wenners/wordclock/drawings/Atemega-328.png

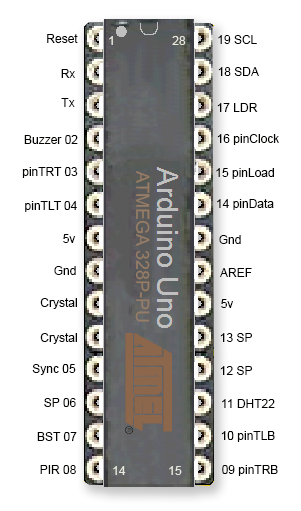
drawings/Atemega-328.png
