wenners/wordclock/drawings/MDF_Bus_Bar.png

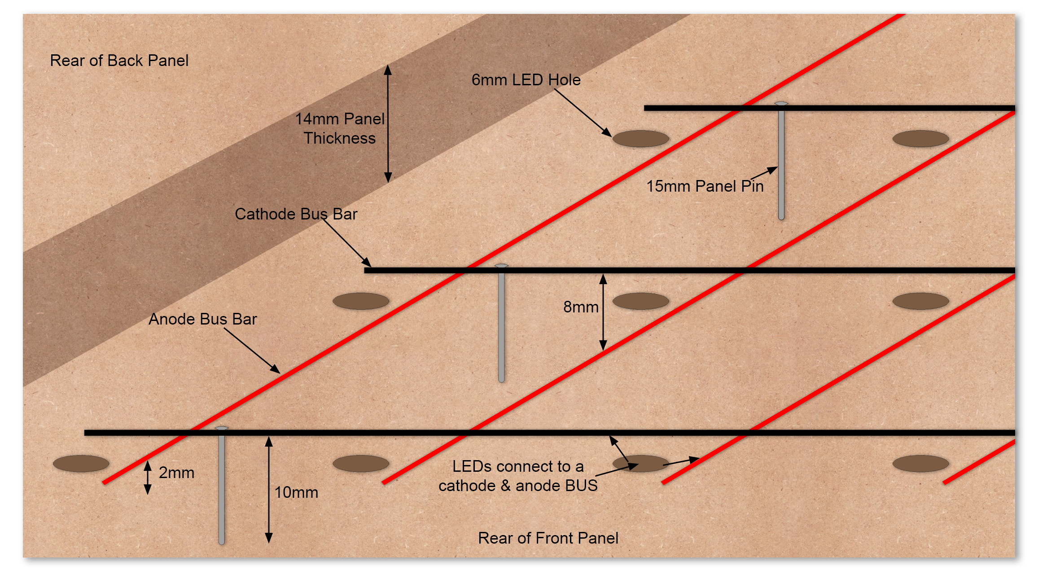
drawings/MDF_Bus_Bar.png
