wenners/wordclock/drawings/Module_layout.png

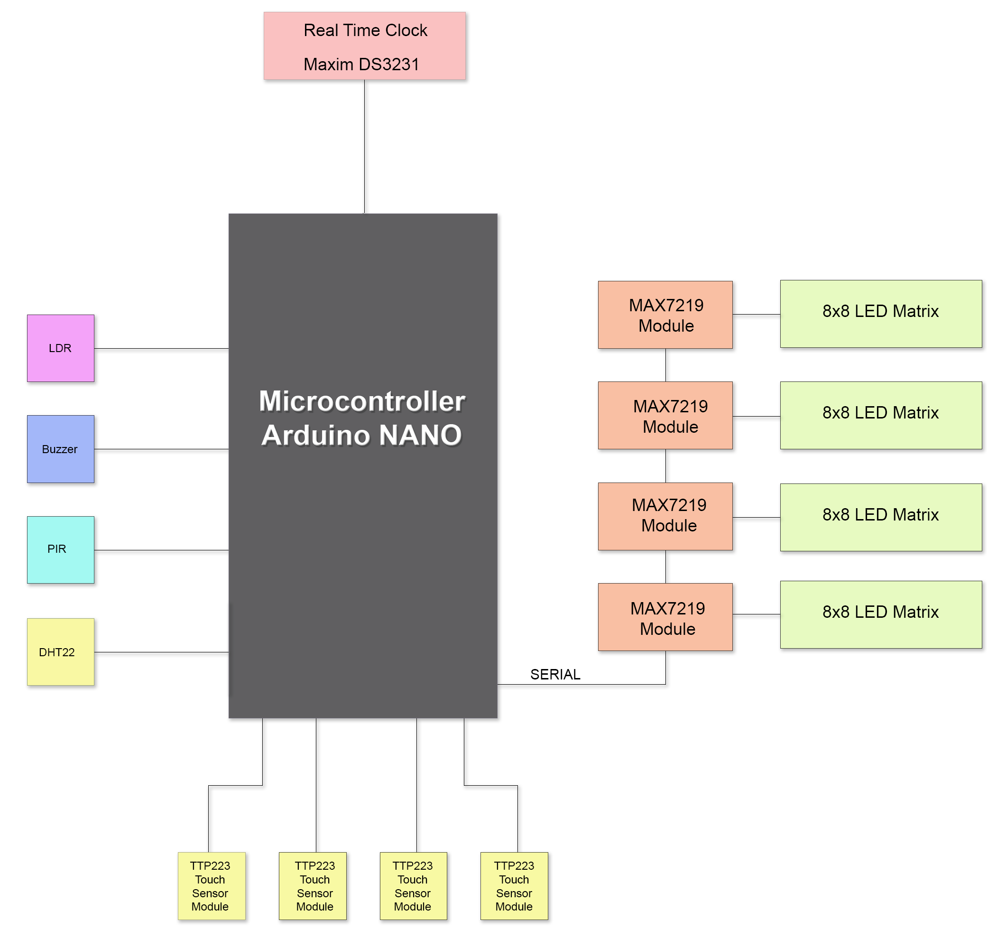
drawings/Module_layout.png
