wenners/wordclock/drawings/PIR_Module.png

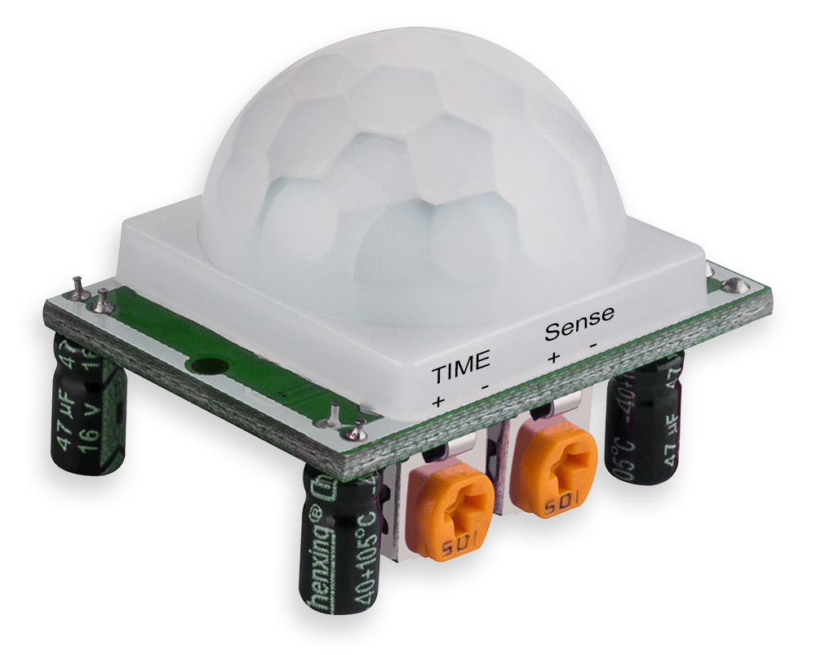
drawings/PIR_Module.png
