wenners/wordclock/drawings/RTC-R5-removal-Mod.png

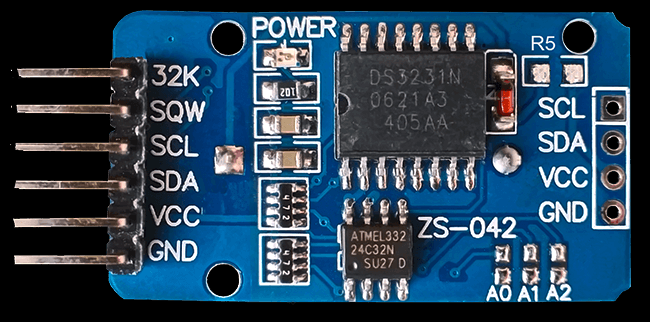
drawings/RTC-R5-removal-Mod.png
