wenners/wordclock/drawings/Touch-Module-Mounting.png

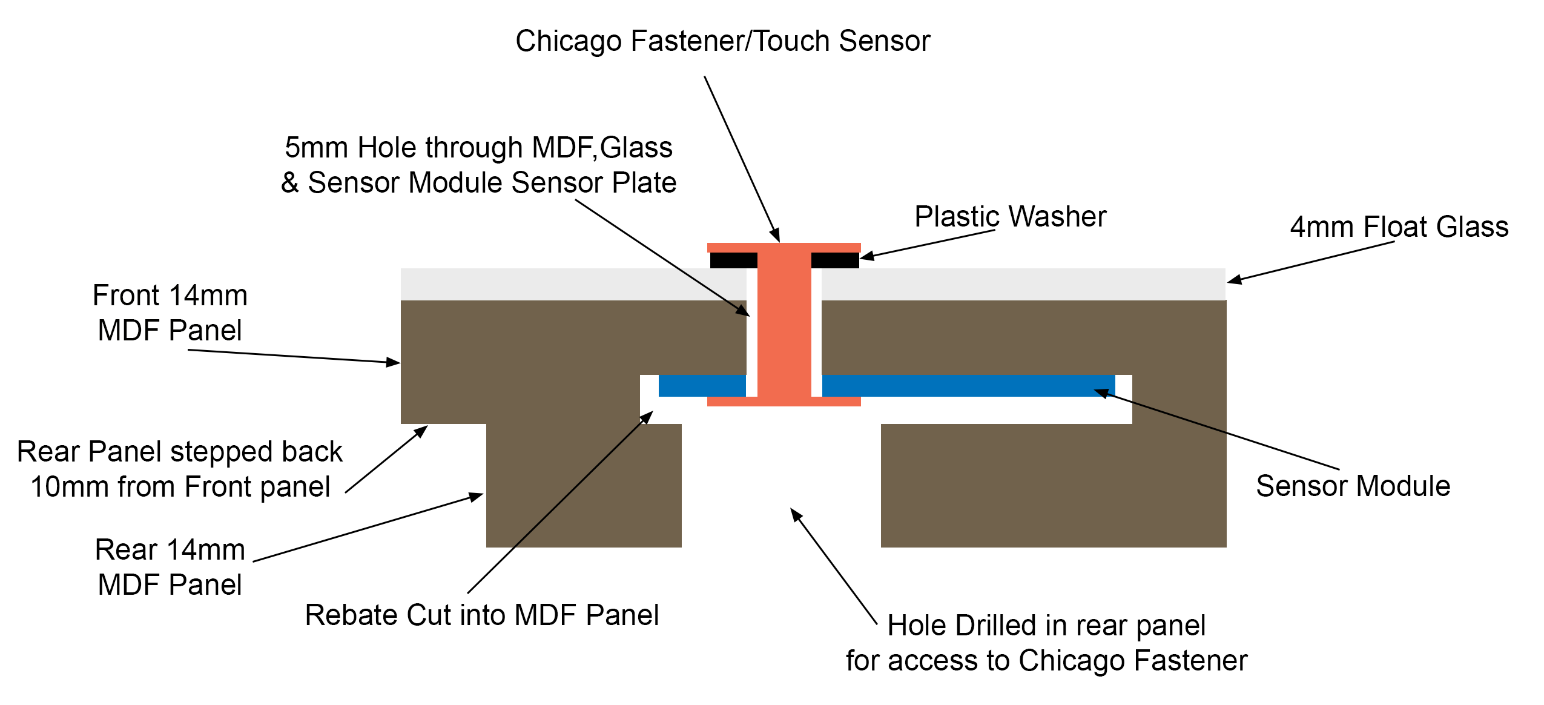
drawings/Touch-Module-Mounting.png
