wenners/wordclock/drawings/Touch-Module-Schematic.png

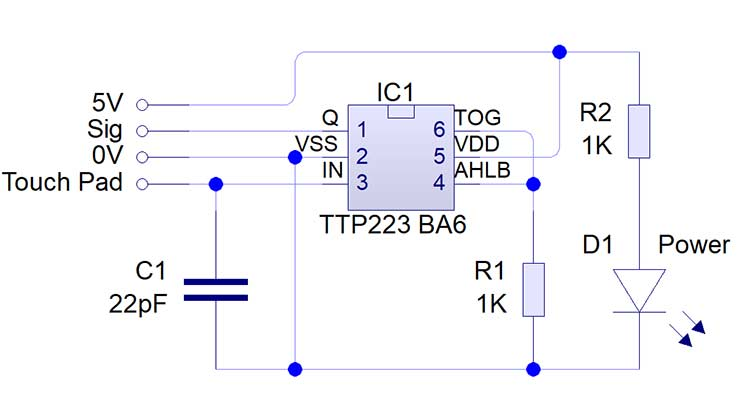
drawings/Touch-Module-Schematic.png
