wenners/wordclock/hardware/main_power01.png

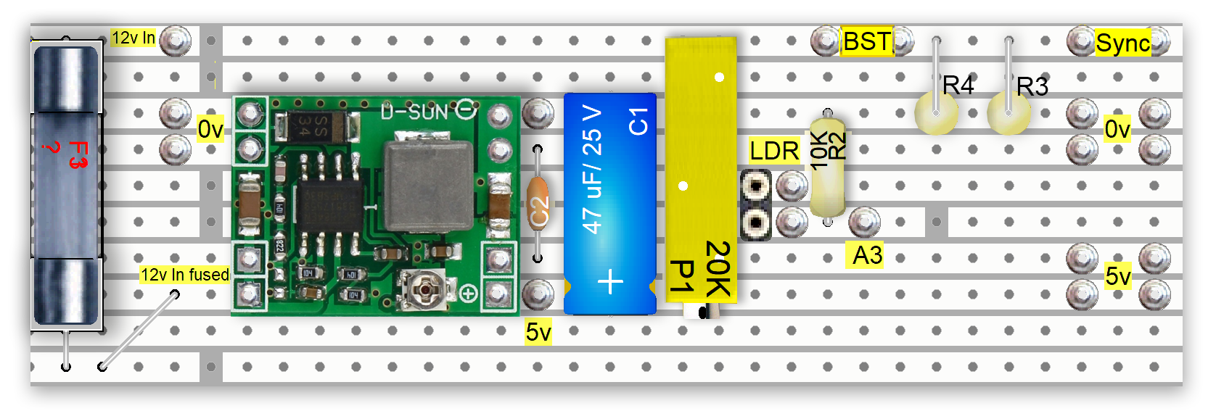
hardware/main_power01.png
