wenners/wordclock/hardware/power_distribution-buzzer.png

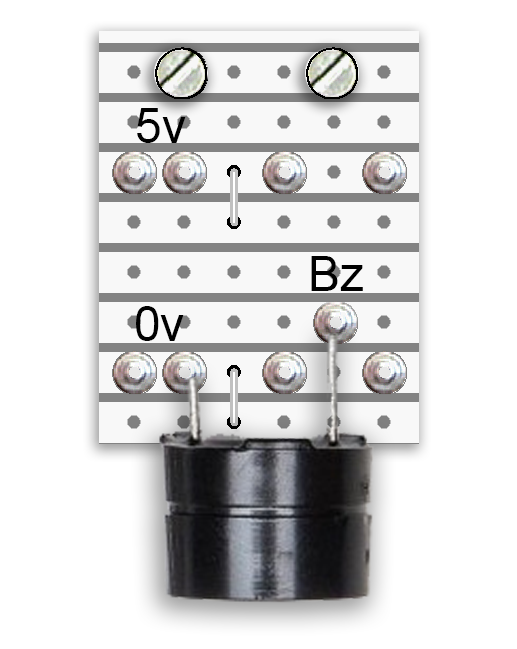
hardware/power_distribution-buzzer.png
