wenners/wordclock/hardware/power_distribution.png

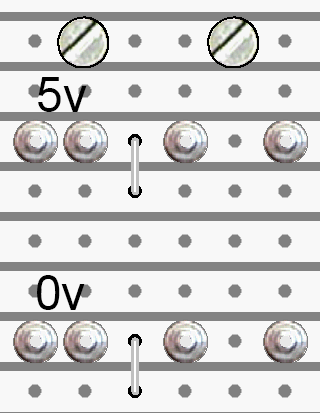
hardware/power_distribution.png
