wenners/wordclock/tables/Word Clock Components.xlsx

Part | Ebay item UK | Qty
10K Resistor 1/4 W |  | 4
20K Variable Resistor |  | 1
Electromagnetic Piezo Buzzer 5v | 181778719109 | 1
LDR L5A20 | 231390322401 | 1
SPST switch |  | 1
TTP223 Touch Sensor Module |  | 4
DHT22 Temperature & Humidity Sensor |  | 1
Arduino NANO |  | 1
DS3231 AT24C32 I2C Precision Real Time Clock Module |  | 1
CR2032 Battery (replaces rechargable RTC battery) |  | 1
Vero Board 35 x 10 holes min |  | 1
MP1584 miniature Power supply module |  | 1
12v 1a PSU |  | 1
MAX7219 Dot Matrix 8x8 Led Display Module |  | 4
2.54mm 0.1" Male Pin Headers Single Row right angle |  | 4
Vero pin Pack |  | 1
Fuse 750mA |  | 1
Fuse Holder |  | 1
LEDs White 13000mCD 120° |  | 256
