wenners/wordclock/tables/LED wiring layout rear.xlsx

 | MODULE 02 |  |  |  |  |  |  |  | MODULE 03
BUS | LED 7 | LED 6 | LED 5 | LED 4 | LED 3 | LED2 | LED 1 | LED 0 | LED DP | LED G | LED F | LED E | LED D | LED C | LED B | LED A | BUS
LED A | D72 | D71 | D70 | D69 | D68 | D67 | D66 | D65 | D192 | D184 | D176 | D168 | D160 | D152 | D144 | D136 | LED 7
LED B | D80 | D79 | D78 | D77 | D76 | D75 | D74 | D73 | D191 | D183 | D175 | D167 | D159 | D151 | D143 | D135 | LED 6
LED C | D88 | D87 | D86 | D85 | D84 | D83 | D82 | D81 | D190 | D182 | D174 | D166 | D158 | D150 | D142 | D134 | LED 5
LED D | D96 | D95 | D94 | D93 | D92 | D91 | D90 | D89 | D189 | D181 | D173 | D165 | D157 | D149 | D141 | D133 | LED 4
LED E | D104 | D103 | D102 | D101 | D100 | D99 | D98 | D97 | D188 | D180 | D172 | D164 | D156 | D148 | D140 | D132 | LED 3
LED F | D112 | D111 | D110 | D109 | D108 | D107 | D106 | D105 | D187 | D179 | D171 | D163 | D155 | D147 | D139 | D131 | LED2
LED G | D120 | D119 | D118 | D117 | D116 | D115 | D114 | D113 | D186 | D178 | D170 | D162 | D154 | D146 | D138 | D130 | LED 1
LED DP | D128 | D127 | D126 | D125 | D124 | D123 | D122 | D121 | D185 | D177 | D169 | D161 | D153 | D145 | D137 | D129 | LED 0
 | MODULE 01 |  |  |  |  |  |  |  | MODULE 04
LED 0 | D1 | D9 | D17 | D25 | D33 | D41 | D49 | D57 | D249 | D250 | D251 | D252 | D253 | D254 | D255 | D256 | LED DP
LED 1 | D2 | D10 | D18 | D26 | D34 | D42 | D50 | D58 | D241 | D242 | D243 | D244 | D245 | D246 | D247 | D248 | LED G
LED 2 | D3 | D11 | D19 | D27 | D35 | D43 | D51 | D59 | D233 | D234 | D235 | D236 | D237 | D238 | D239 | D240 | LED F
LED 3 | D4 | D12 | D20 | D28 | D36 | D44 | D52 | D60 | D225 | D226 | D227 | D228 | D229 | D230 | D231 | D232 | LED E
LED 4 | D5 | D13 | D21 | D29 | D37 | D45 | D53 | D61 | D217 | D218 | D219 | D220 | D221 | D222 | D223 | D224 | LED D
LED5 | D6 | D14 | D22 | D30 | D38 | D46 | D54 | D62 | D209 | D210 | D211 | D212 | D213 | D214 | D215 | D216 | LED C
LED6 | D7 | D15 | D23 | D31 | D39 | D47 | D55 | D63 | D201 | D202 | D203 | D204 | D205 | D206 | D207 | D208 | LED B
LED 7 | D8 | D16 | D24 | D32 | D40 | D48 | D56 | D64 | D193 | D194 | D195 | D196 | D197 | D198 | D199 | D200 | LED A
BUS | LED A | LED B | LED C | LED D | LED E | LED F | LED G | LED DP | LED 0 | LED 1 | LED 2 | LED 3 | LED 4 | LED5 | LED6 | LED 7 | BUS
