wenners/wordclock/(commit log)

2017-12-14 First commit
    This clock hardware is based on the original Word Clock by Wouter Devinck and the "Catalan" Pijuana Word Clock software by svcabre
    [LED wiring layout rear.xlsx, MAX7219 Rset value.xlsx, Switches.xlsx, Word Clock Components.xlsx, Word to Time Translations.xlsx, wordclock-ledboard.brd, wordclock-ledboard.sch, wordclock-mainboard.brd]
2021-10-26 change Folder name for Arduino IDE
